WilliamZhang20/Temp-Aware-Mug/Design Files/ECE198_Schemetic.pdf

↳.S ⑤
I ↳

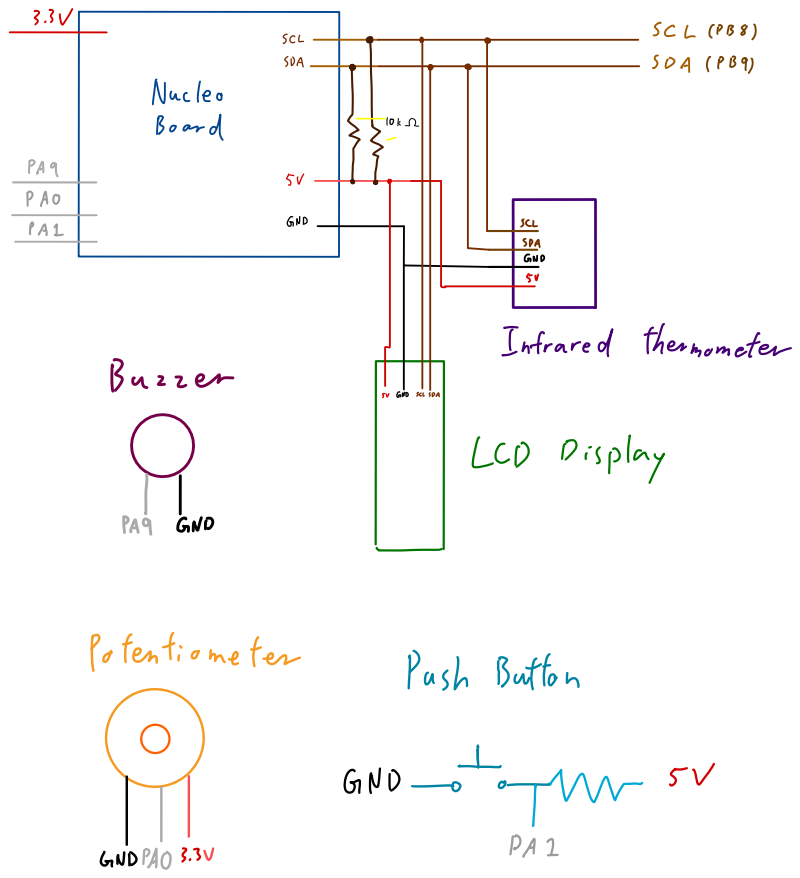
[picture p4: page 1]
SPA; SDA(P139); Nucleo; Board; B uzzer; SCL; SCL(PB8); PAO; PAI; GND; Infrared thermometer; GND S2L SPA; Display LC; PA9 GND; Potentiometer; Push Button; PA 1 GNDPA8 3. 32

GND-otoTMr SV
