WilliamZhang20/Temp-Aware-Mug/Core/Src/main.c

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
/* Includes ------------------------------------------------------------------*/
#include "main.h"

/* USER CODE BEGIN Includes */
#include <string.h>
#include <stdbool.h>
#include <stdio.h>
#include <float.h>
#include <stdio.h>
#include <stdlib.h>
/* USER CODE END Includes */

ADC_HandleTypeDef hadc1;

I2C_HandleTypeDef hi2c1;

UART_HandleTypeDef huart2;

void SystemClock_Config(void);
static void MX_GPIO_Init(void);
static void MX_USART2_UART_Init(void);
static void MX_I2C1_Init(void);
static void MX_ADC1_Init(void);
/* USER CODE BEGIN 0 */

enum stage { reset, set_temp, watch_temp, buzz };

/* USER CODE END 0 */

/**
  * @brief  The application entry point.
  * @retval int
  */
int main(void)
{
  /* MCU Configuration--------------------------------------------------------*/

  /* Reset of all peripherals, Initializes the Flash interface and the Systick. */
  HAL_Init();

  /* USER CODE BEGIN Init */
  uint16_t potentiometerValue;
  uint16_t user_temp = 20;
  uint16_t init_temp;
  enum stage curr = reset;
  /* USER CODE END Init */

  /* Configure the system clock */
  SystemClock_Config();

  /* Initialize all configured peripherals */
  MX_GPIO_Init();
  MX_USART2_UART_Init();
  MX_I2C1_Init();
  MX_ADC1_Init();
  /* USER CODE BEGIN 2 */
  // Display vars below:
  HD44780_Init(2);
  HD44780_Clear();
  HD44780_SetCursor(0,0);
  HD44780_PrintStr("Hi there!");
  HAL_Delay(1700);
  HD44780_Clear();
  /* USER CODE END 2 */

  /* Infinite loop */
  /* USER CODE BEGIN WHILE */
  while (1)
  {
	  if(curr==reset) {
		  if(HAL_GPIO_ReadPin(GPIOA, GPIO_PIN_1) == 0) {
			  curr = set_temp;
			  // Take temperature measurement
			  char i2cdata[2];
			  float temperature;
			  HAL_I2C_Mem_Read(&hi2c1, 0xB4, 0x07, 1, (uint8_t*)i2cdata, 2, 100);
			  int raw_temp = ((i2cdata[1] << 8) | (i2cdata[0]));
			  temperature = raw_temp*0.02 - 273.15;
			  init_temp = temperature;
			  HAL_Delay(10);
			  // Print to display
			  HD44780_Clear();
			  HD44780_SetCursor(0,0);
			  char tempString[10];
			  sprintf(tempString, "%d", (int)temperature);
			  HD44780_PrintStr("Measured temperature:");
			  HD44780_SetCursor(0,1);
			  HD44780_PrintStr(tempString);
			  HAL_Delay(1000);
		  } else {
			  HD44780_Clear();
			  HD44780_SetCursor(0,0);
			  HD44780_PrintStr("Push button");
			  HD44780_SetCursor(0, 1);
			  HD44780_PrintStr("to start");
			  HAL_Delay(1);
		  }
	  } else if(curr==set_temp) {
		  HAL_ADC_Start(&hadc1); // take potentiometer input
		  HAL_ADC_PollForConversion(&hadc1, HAL_MAX_DELAY);
		  potentiometerValue = HAL_ADC_GetValue(&hadc1); // take potentiometer value
		  uint16_t targetTemp = ((potentiometerValue)*(init_temp - 20)/4095)+20; // LINEAR INTERPOLATION FORMULA
		  // Set display params
		  HD44780_Clear();
		  HD44780_SetCursor(0,0);
		  HD44780_PrintStr("Set temperature:"); // print message and temperature
		  char tempString[10];
		  sprintf(tempString, "%hu", targetTemp);
		  HD44780_SetCursor(0,1);
		  HD44780_PrintStr(tempString); // temperature out!
		  HAL_Delay(10);
		  if(HAL_GPIO_ReadPin(GPIOA, GPIO_PIN_1) == 0) {
			  user_temp = targetTemp;
			  curr = watch_temp;
		  }
	  } else if(curr==watch_temp) {
		  // TODO: take temperature measurement -> DONE
		  char i2cdata[2];
		  float temperature;
		  HAL_I2C_Mem_Read(&hi2c1, 0xB4, 0x07, 1, (uint8_t*)i2cdata, 2, 100);
		  int raw_temp = ((i2cdata[1] << 8) | (i2cdata[0]));
		  temperature = raw_temp*0.02 - 273.15;
		  // TODO: print to display -> DONE
		  HD44780_Clear();
		  HD44780_SetCursor(0,0);
		  char tempString[10];
		  sprintf(tempString, "%d", (int)temperature);
		  HD44780_PrintStr("Measured temp:");
		  HD44780_PrintStr(tempString);
		  // TODO: compare with user temp, if close, then BUZZ -> DONE
		  HAL_Delay(1000); // allows user one second before buzz check and activate
		  if(abs(user_temp - temperature)<5) {
			  curr = buzz;
			  continue;
		  } else if(temperature < user_temp) {
			  curr = buzz; // new redundancy feature - if both user_temp and temperature are high but if cup pulled away...
			  continue;
		  }
		  HAL_Delay(9000); // between temp measurements, an overall delay of 10 seconds (subject to change)
	  } else if(curr==buzz) {
		  HAL_GPIO_WritePin(GPIOA, GPIO_PIN_9, GPIO_PIN_SET);
		  HAL_Delay(500);
		  HAL_GPIO_WritePin(GPIOA, GPIO_PIN_9, GPIO_PIN_RESET);
		  // Print display prompt
		  HD44780_Clear();
		  HD44780_SetCursor(0,0);
		  HD44780_PrintStr("Push button");
		  HD44780_SetCursor(0, 1);
		  HD44780_PrintStr("to stop");
		  HAL_Delay(1);
		  if(HAL_GPIO_ReadPin(GPIOA, GPIO_PIN_1) == 0) {
			  curr = reset;
			  HAL_Delay(1000); // bug fix - delay
		  }
	  }
    /* USER CODE END WHILE */
    /* USER CODE BEGIN 3 */
  }
  HD44780_Clear();
  /* USER CODE END 3 */
}

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
