WilliamZhang20/Temp-Aware-Mug/(commit log)

2023-11-12 restart dev, add console printing with I2C
    [ECE_198 Debug.cfg]
2023-11-13 configure basic display variable printing
2023-11-13 add current temperature sensor functions
2023-11-14 made temperature detection work
2023-11-15 print measured temperature on display
